TheRandomClik/Slider-Open-Source-SPARC-PLAnt/README.md

# Slider: An Open Source SPARC Compliant PLAnt
An open-source and free-to-use SPARC-compliant PLAnt design for the Repeat Open PLAnt Challenge.

Repeat Open PLAnt Challenge: https://repeat-robotics.com/blogs/b/repeat-open-plant-challenge

Repeat Open PLAnt Bundle: https://repeat-robotics.com/products/open-plant-bundle

# About Slider
Slider was designed for the Repeat Open PLAnt Challenge. Based on the v1 CAD of the successful Bergentruck, Slider has numerous improvements, including:
- Simplified wiring
- Minimized hardware types
- Improved armor durability
- Improved ground game

# Design Objectives
- Highly modular and customizable armor/ground game packages
- Wide vertical spinner archetype to take advantage of aggressive and smothering driving style
- Provide equal, if not greater, combat performance and durability compared to Bergentruck v1

# Assembly Guide
See SliderAssembly.pdf
