TheRandomClik/Slider-Open-Source-SPARC-PLAnt/SliderMainAssembly.step

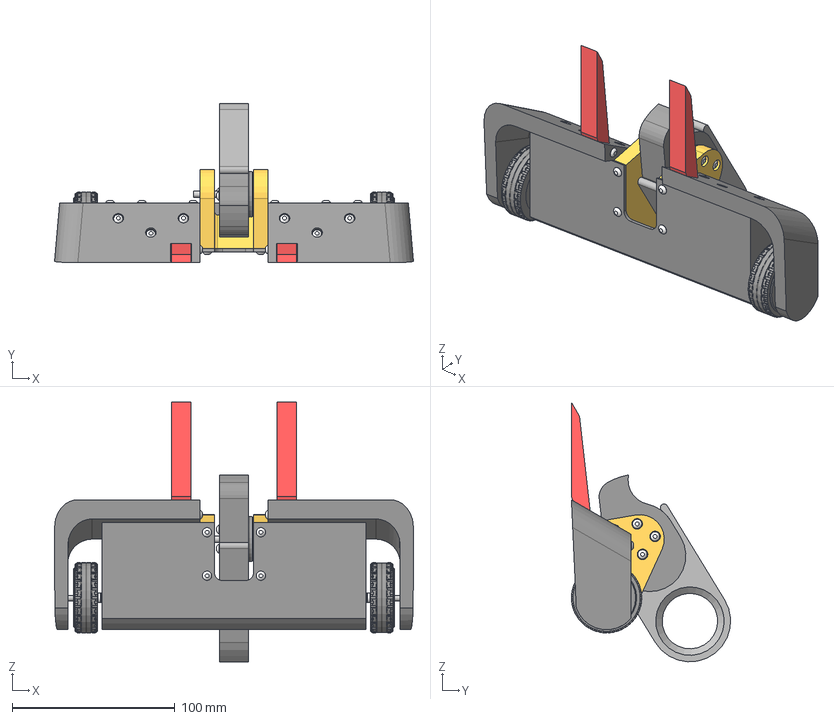
[picture p1: CAD file, 2026-10-25]
SliderMainAssembly.step
220.3 x 97.7 x 159.3 mm
M3x8 Plastite x 18
bergPfDriveMotorRetainer x 2
bergPfLid x 2
bergPfRightWedge
Mini Brushed Mk2
Move Face1
M2x5 x 2
3S 380 mAh GNB Lipo
F-06A Reciever
bergPfChassis
M3x25 x 2
bergPfWeaponLock
M3x8 x 10
LEGO Tire 43.2x14 x 2
43.2x14 Tire Hub-Mirrored
Gold Screw Hub-Mirrored
Gold Screw Hub
43.2x14 Tire Hub
bergPfFork x 2
bergPfMotorSupport
bergPfWeapon
Repeat 2822 Mk3
HK0408 Needle Bearing
bergPfMotorMount
Repeat Screw Switch
bergPfLeftWedge
Mini Brushed Mk2-Mirrored
