TheRandomClik/Slider-Open-Source-SPARC-PLAnt/Printed Parts/SliderChassis.step

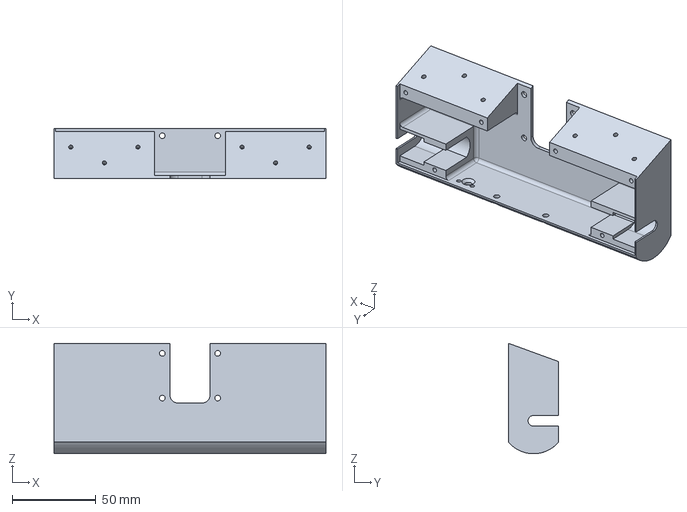
[picture p2: CAD file, 2026-10-25]
Printed Parts/SliderChassis.step
162.0 x 30.0 x 65.8 mm
