TheRandomClik/Slider-Open-Source-SPARC-PLAnt/Printed Parts/SliderWeaponLock.step

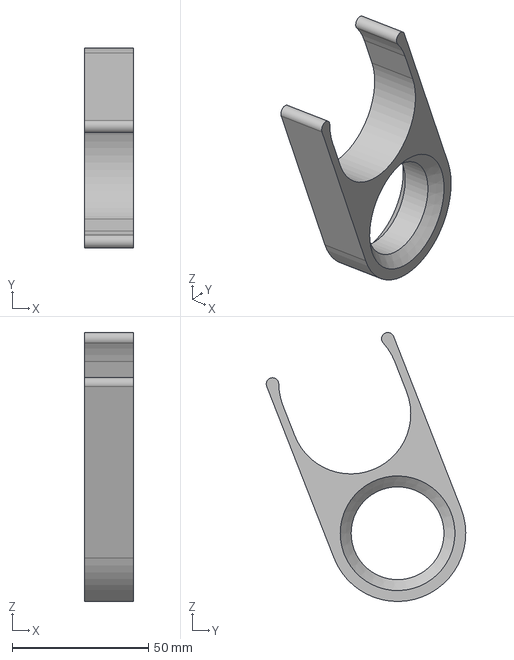
[picture p3: CAD file, 2026-10-25]
Printed Parts/SliderWeaponLock.step
18.0 x 73.1 x 98.6 mm
