TheRandomClik/Slider-Open-Source-SPARC-PLAnt/Printed Parts/SliderDriveMotorRetainer.step

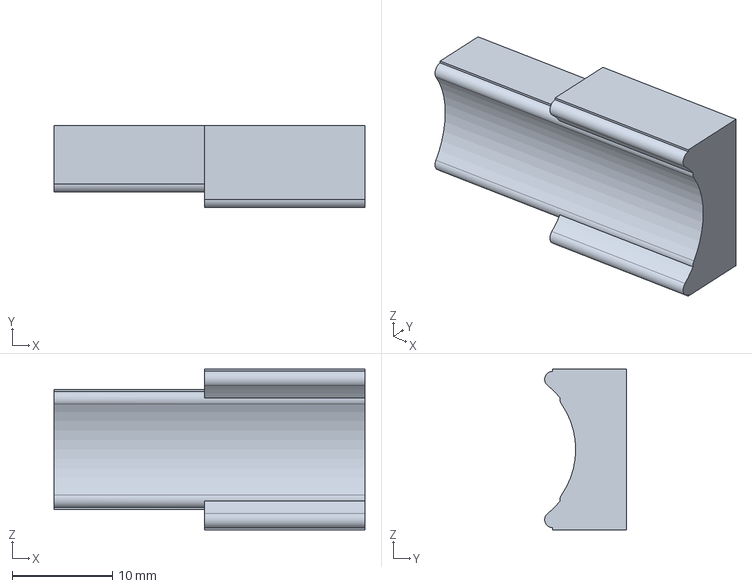
[picture p4: CAD file, 2026-10-25]
Printed Parts/SliderDriveMotorRetainer.step
31.0 x 8.14 x 16.0 mm
