TheRandomClik/Slider-Open-Source-SPARC-PLAnt/Printed Parts/SliderSpinner.step

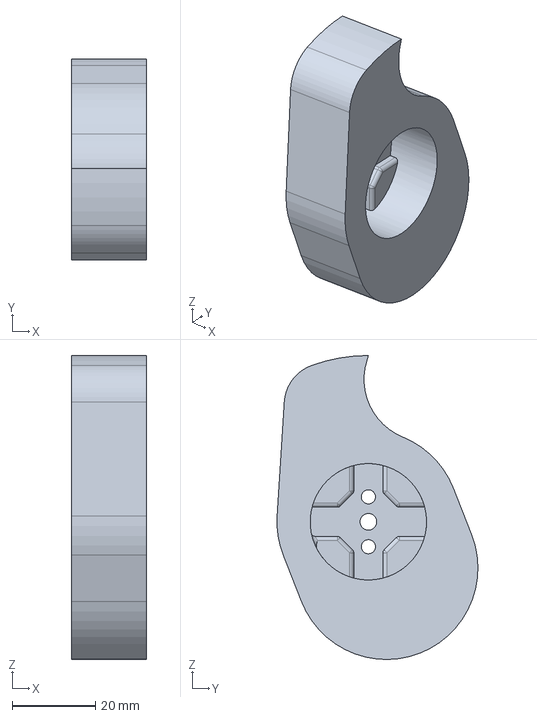
[picture p5: CAD file, 2026-10-25]
Printed Parts/SliderSpinner.step
18.0 x 48.3 x 73.1 mm
