TheRandomClik/Slider-Open-Source-SPARC-PLAnt/Printed Parts/SliderMotorMount.step

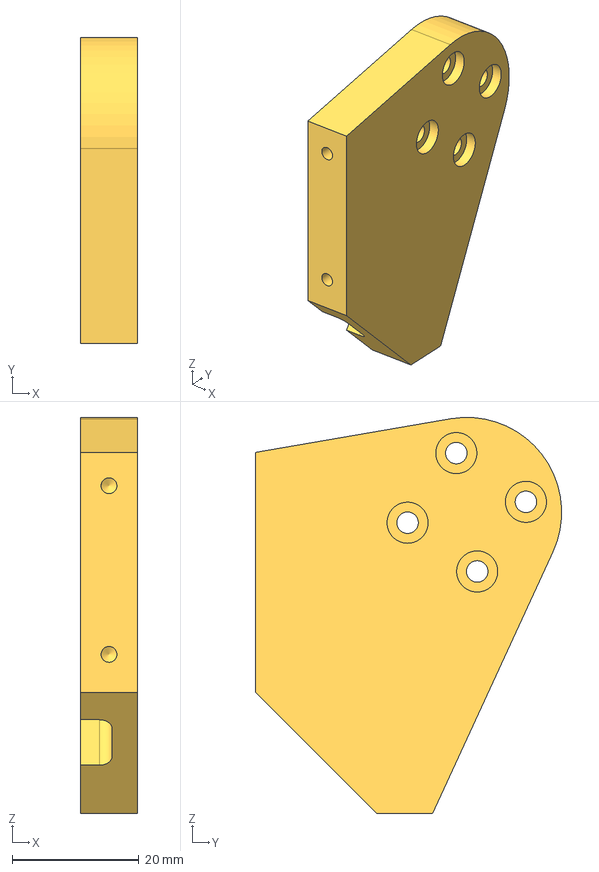
[picture p6: CAD file, 2026-10-25]
Printed Parts/SliderMotorMount.step
9.00 x 48.4 x 62.6 mm
