TheRandomClik/Slider-Open-Source-SPARC-PLAnt/Printed Parts/SliderLid.step

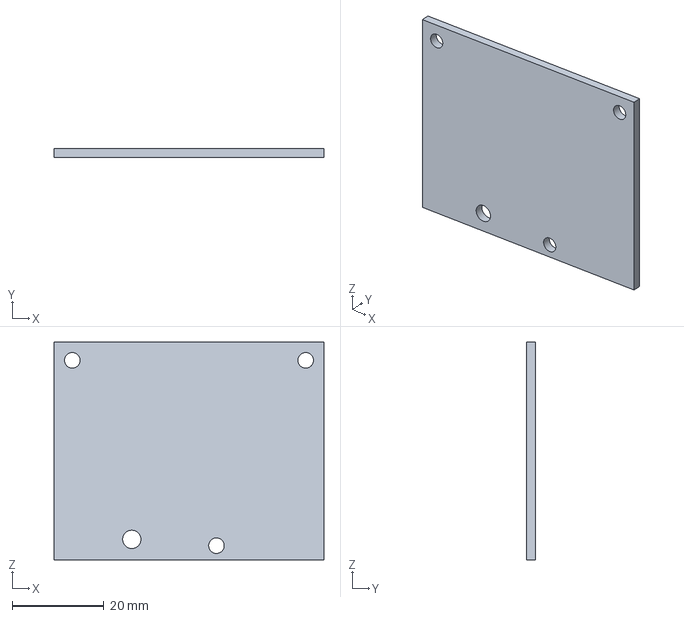
[picture p7: CAD file, 2026-10-25]
Printed Parts/SliderLid.step
59.0 x 2.00 x 47.6 mm
