TheRandomClik/Slider-Open-Source-SPARC-PLAnt/Printed Parts/SliderWheelHub.step

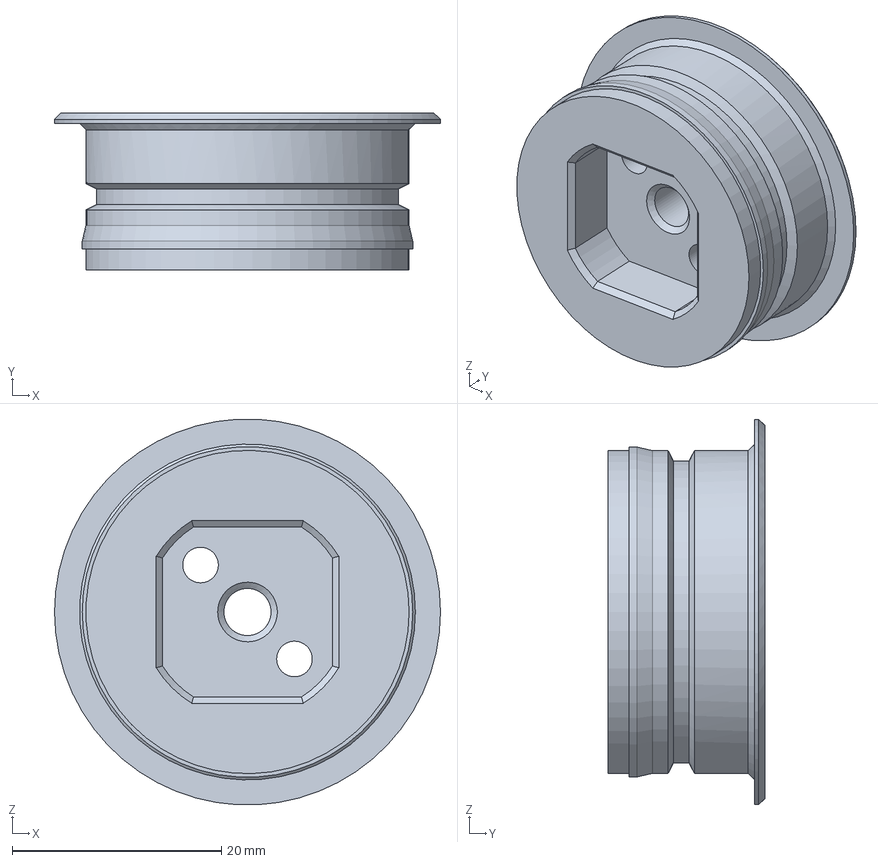
[picture p8: CAD file, 2026-10-25]
Printed Parts/SliderWheelHub.step
36.9 x 15.0 x 36.8 mm
