TheRandomClik/Slider-Open-Source-SPARC-PLAnt/Printed Parts/SliderRightArmor.step

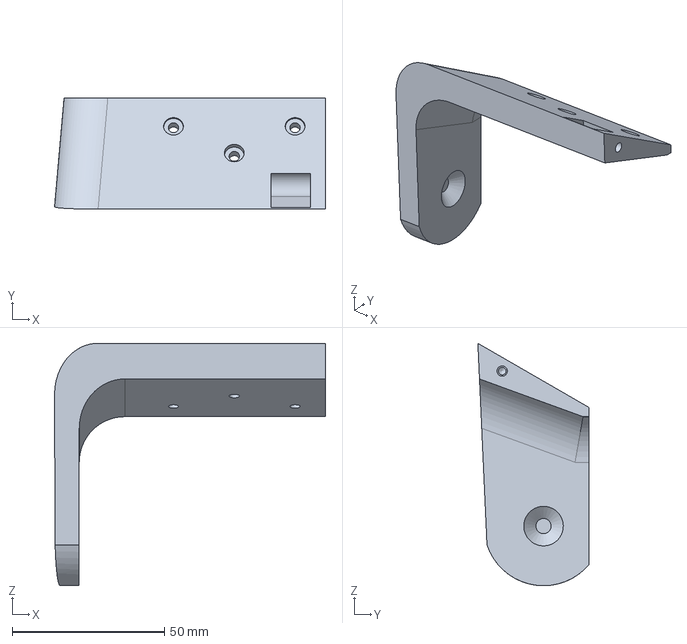
[picture p9: CAD file, 2026-10-25]
Printed Parts/SliderRightArmor.step
89.1 x 36.6 x 79.7 mm
