TheRandomClik/Slider-Open-Source-SPARC-PLAnt/Printed Parts/SliderFork.step

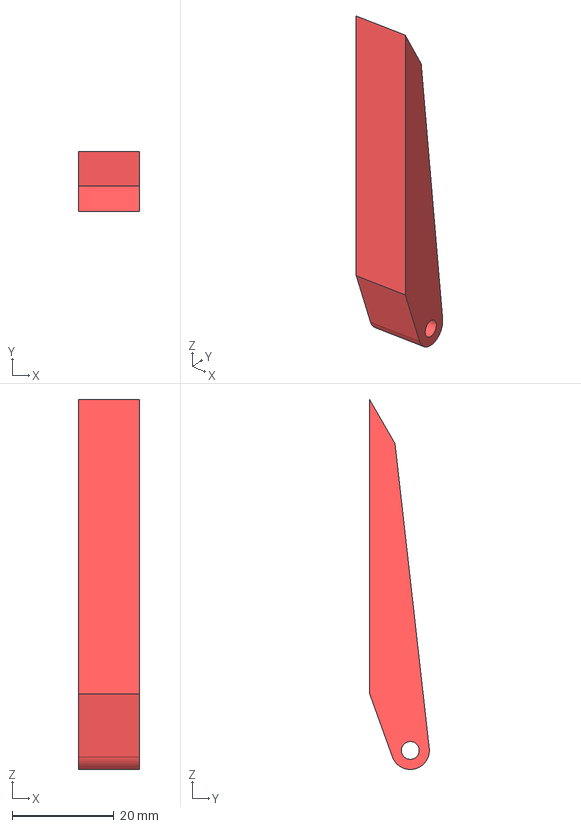
[picture p10: CAD file, 2026-10-25]
Printed Parts/SliderFork.step
12.0 x 11.7 x 72.7 mm
