TheRandomClik/Slider-Open-Source-SPARC-PLAnt/Printed Parts/SliderMotorSupport.step

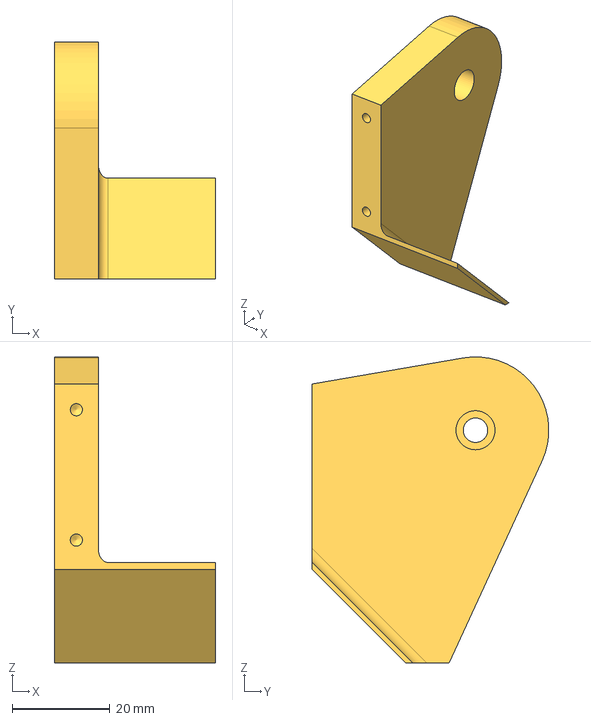
[picture p11: CAD file, 2026-10-25]
Printed Parts/SliderMotorSupport.step
33.0 x 48.4 x 62.6 mm
