TheRandomClik/Slider-Open-Source-SPARC-PLAnt/(list of files, cad)

Other CAD files:
Printed Parts/SliderLeftArmor.step
