TheRandomClik/Slider-Open-Source-SPARC-PLAnt/(commit log)

2026-10-25 Added Assembly Guide
2026-10-25 Added Main Assembly .step file
    [SliderMainAssembly.step]
2026-10-25 Added individual files for printing
    [SliderChassis.step, SliderDriveMotorRetainer.step, SliderFork.step, SliderLeftArmor.step, SliderLid.step, SliderMotorMount.step, SliderMotorSupport.step, SliderRightArmor.step]
